CodeKi0303/split-beat-he-hardware/manufacturing/pcb/c86-panel-bom-R609-DNP-REVIEW.csv

Comment | Designator | Footprint | LCSC Part #
1206W4F1200T5E | R503,R553 | R_1206_3216Metric | C17909
74437324022 | L220,L320 | L_Wuerth_74437324022 | C2651177
AO3401A | Q212,Q312 | SOT-23 | C15127
BLM18PG121SN1D | FB210,FB310 | L_0603_1608Metric | C14709
C0805C475K4RACTU | C220,C235,C320,C335,C415,C417 | C_0805_2012Metric | C7224519
CPG151101S11-16 | SW1201,SW1204,SW1301,SW1304 | MX_Hotswap_Kailh_CPG151101S11_NPTH | C41430893
RC0603JR-070RL | R603 | R_0603_1608Metric | C95177
ECS-3225MV-240-CN-TR | X401 | ECS_3225MV_3.2x2.5mm | C405478
OXETDLJANF-25MHZ | X210,X310 | ECS_3225MV_3.2x2.5mm | C5382666
GRM1885C1H102JA01D | C1401,C1402,C1403,C1501,C1502,C1503 | C_0603_1608Metric | C77026
GRM188R71A225KE15D | C237,C238,C337,C338 | C_0603_1608Metric | C86018
GRM188R72A104KA35D | C1001,C1002,C1003,C1004,C1005,C1006,C1007,C1101,C1102,C1103,C1104,C1105,C1106,C1107,C211,C212,C221,C230,C231,C232,C233,C234,C236,C239,C311,C312,C321,C330,C331,C332,C333,C334,C336,C339,C410,C411,C412,C413,C414,C416,C418,C501,C551,C607,C608,C701 | C_0603_1608Metric | C77058
GRM21BR71C105KA01L | C240,C340,C401,C502,C552,C601,C602,C603,C604,C605,C606,C702 | C_0805_2012Metric | C77079
GRM21BR71C106KE51L | C222,C223,C322,C323 | C_0805_2012Metric | C408142
LM66100DCKR | U601,U603,U606 | SOT-363_SC-70-6 | C2869734
PEC11R-4215F-S0024 | ENC1401,ENC1501 | Bourns_PEC11R_4215F_S0024_Centered | C143790
RC0603FR-07100KL | R213,R215,R216,R221,R313,R315,R316,R321,R407,R501,R502,R504,R551,R552,R556,R601,R606 | R_0603_1608Metric | C14675
RC0603FR-0710KL | R1211,R1212,R1213,R1214,R1311,R1312,R1313,R1314,R1411,R1412,R1413,R1511,R1512,R1513,R214,R314,R404,R602,R604,R605,R607,R608 | R_0603_1608Metric | C98220
RC0603FR-0712KL | R405 | R_0603_1608Metric | C114659
RC0603FR-071KL | R1001,R1002,R1003,R1004,R1005,R1006,R1007,R1101,R1102,R1103,R1104,R1105,R1106,R1107,R1201,R1202,R1203,R1204,R1301,R1302,R1303,R1304,R1401,R1402,R1403,R1501,R1502,R1503 | R_0603_1608Metric | C22548
RC0603FR-07453KL | R220,R320 | R_0603_1608Metric | C273765
RC0603FR-074K7L | R701,R702 | R_0603_1608Metric | C99782
RC0603FR-075K1L | R401,R402,R554,R555 | R_0603_1608Metric | C105580
RC0603FR-07820RL | R403 | R_0603_1608Metric | C114638
SN74LVC1G32DBVR | U605 | SOT-23-5 | C10096
SS39ET | U1001,U1002,U1003,U1004,U1005,U1006,U1007,U1101,U1102,U1103,U1104,U1105,U1106,U1107 | SOT-23 | C126669
STM32H723VGT6 | U210,U310 | LQFP-100_14x14mm_P0.5mm | C730142
THVD1450DR | U501,U551 | SOIC-8_3.9x4.9mm_P1.27mm | C2671361
TLV62569DBVR | U220,U320 | SOT-23-5 | C141836
TPD1E10B06DYAR | D403,D504,D554 | D_SOD-523 | C3712135
TPD2E007DCKR | D502,D552 | SOT-323_SC-70 | C464811
TPD2E2U06DCKR | D402,D503,D553 | SOT-323_SC-70 | C1855726
TPD2EUSB30ADRTR | D401 | Texas_DRT-3 | C94934
TPS2552DBVR | U602 | SOT-23-6 | C46506
TS-1088-AR02016 | SW210,SW211,SW310,SW311 | SW_SPST_TS-1088-xR020 | C720477
FUSB303BTMX | U604 | onsemi_QFN12_722AG_1.6x1.6mm_P0.4mm | C895444
USB3300-EZK | U401 | QFN-32-1EP_5x5mm_P0.5mm_EP3.3x3.3mm | C108954
USB4105-GF-A-120 | J401,J501,J551 | USB_C_Receptacle_GCT_USB4105-xx-A_16P_TopMnt_Horizontal_JLC_NPTH | C5184243
PZ254R-11-05P | L_J74_SWD,R_J74_SWD | PinHeader_1x05_P2.54mm_Horizontal_C74_D1p1 | C492413
RC0603FR-07887KL | R610,R611 | R_0603_1608Metric | C246015
