CodeKi0303/split-beat-he-hardware/manufacturing/knob-bezels/D20-right-bezel-PRINT-FIT-TRIAL-NOT-ORDER.stl

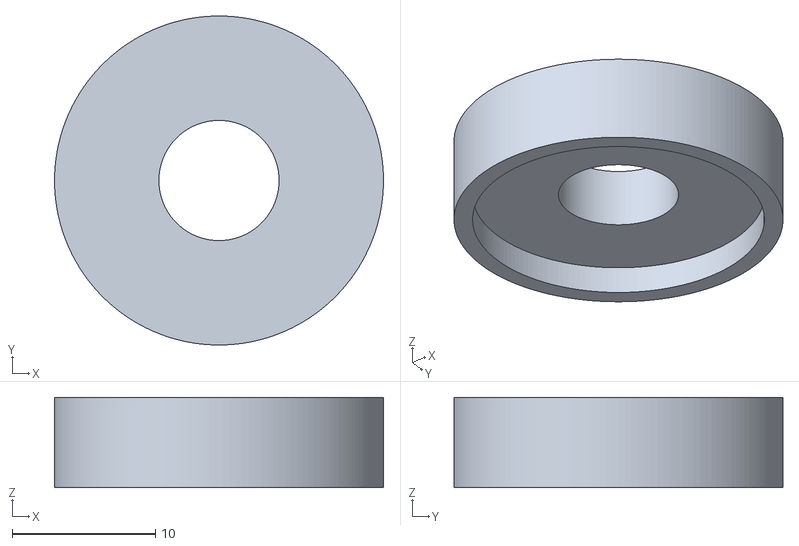
[picture p1: CAD file, 2026-11-08]
manufacturing/knob-bezels/D20-right-bezel-PRINT-FIT-TRIAL-NOT-ORDER.stl
23.0 x 23.0 x 6.30
