CodeKi0303/split-beat-he-hardware/manufacturing/plates/as-built/C77-R-LOWER-AL1p5-ALL-M3-WHEEL-CANDIDATE.step

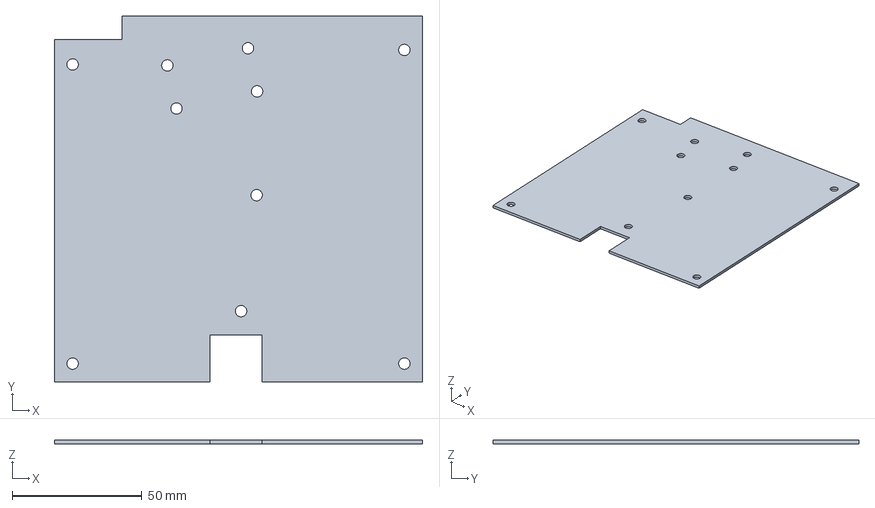
[picture p5: CAD file, 2026-11-08]
manufacturing/plates/as-built/C77-R-LOWER-AL1p5-ALL-M3-WHEEL-CANDIDATE.step
142.0 x 141.1 x 1.50 mm
