CodeKi0303/split-beat-he-hardware/manufacturing/plates/fit-candidate/FIT-CANDIDATE-L-LOWER-AL1p5-138x137p05.step

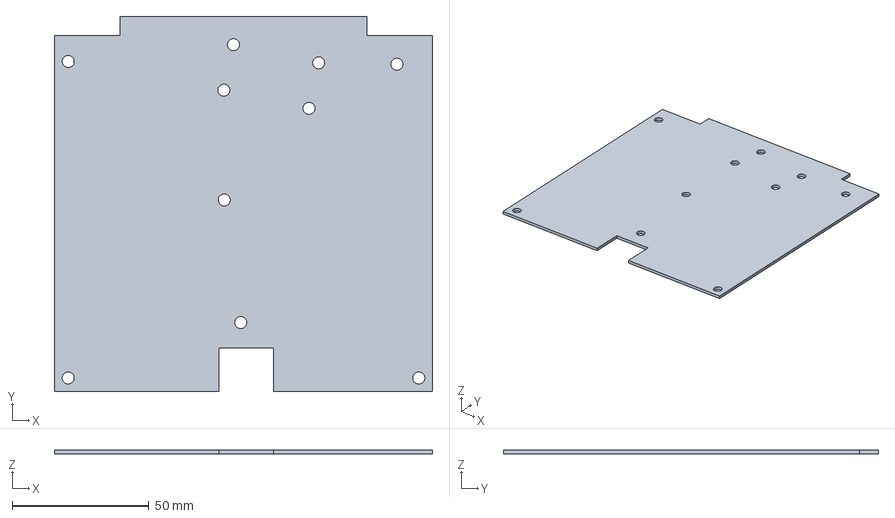
[picture p6: CAD file, 2026-11-08]
manufacturing/plates/fit-candidate/FIT-CANDIDATE-L-LOWER-AL1p5-138x137p05.step
138.0 x 137.1 x 1.50 mm
