CodeKi0303/split-beat-he-hardware/(list of files, cad)

Other CAD files:
manufacturing/knob-bezels/D20-left-bezel-PRINT-FIT-TRIAL-NOT-ORDER.stl
manufacturing/plates/fit-candidate/FIT-CANDIDATE-R-UPPER-AL1p5-138x137p05.step
manufacturing/knob-bezels/08-D20-LEFT-BEZEL.stl
manufacturing/plates/as-built/C80-R-UPPER-AL1p5-FIX-NELSON.step
manufacturing/plates/as-built/C77-L-LOWER-AL1p5-ALL-M3-WHEEL-CANDIDATE.dxf
manufacturing/plates/as-built/C77-R-LOWER-AL1p5-ALL-M3-WHEEL-CANDIDATE.dxf
manufacturing/plates/fit-candidate/FIT-CANDIDATE-L-LOWER-AL1p5-138x137p05.dxf
manufacturing/plates/fit-candidate/FIT-CANDIDATE-L-UPPER-AL1p5-138x137p05.dxf
manufacturing/plates/fit-candidate/FIT-CANDIDATE-R-LOWER-AL1p5-138x137p05.dxf
manufacturing/plates/fit-candidate/FIT-CANDIDATE-R-UPPER-AL1p5-138x137p05.dxf
