CodeKi0303/split-beat-he-hardware/pcb/board/split-hall-c86-four-layer-REVIEW-NOT-ORDER.kicad_pcb

## KiCad design pcb/board/split-hall-c86-four-layer-REVIEW-NOT-ORDER.kicad_pcb (2026-11-08)

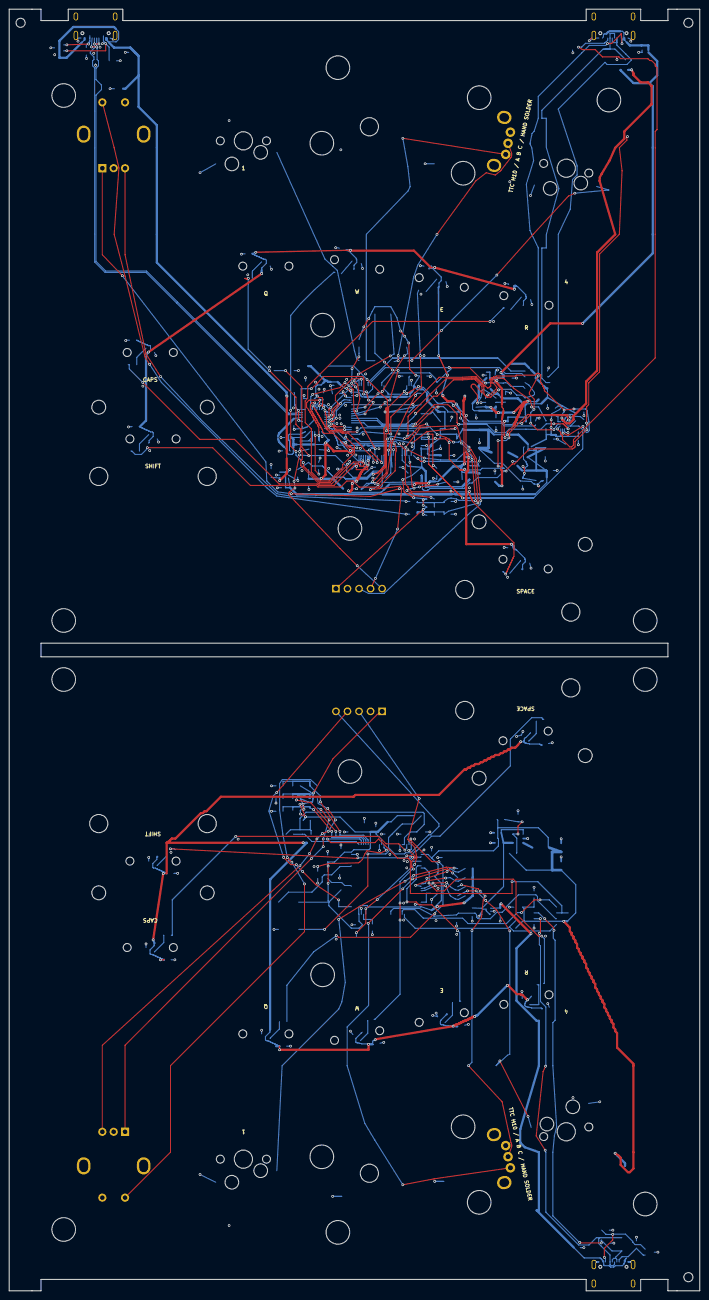
[picture p7: board split-hall-c86-four-layer-REVIEW-NOT-ORDER.kicad_pcb from above]

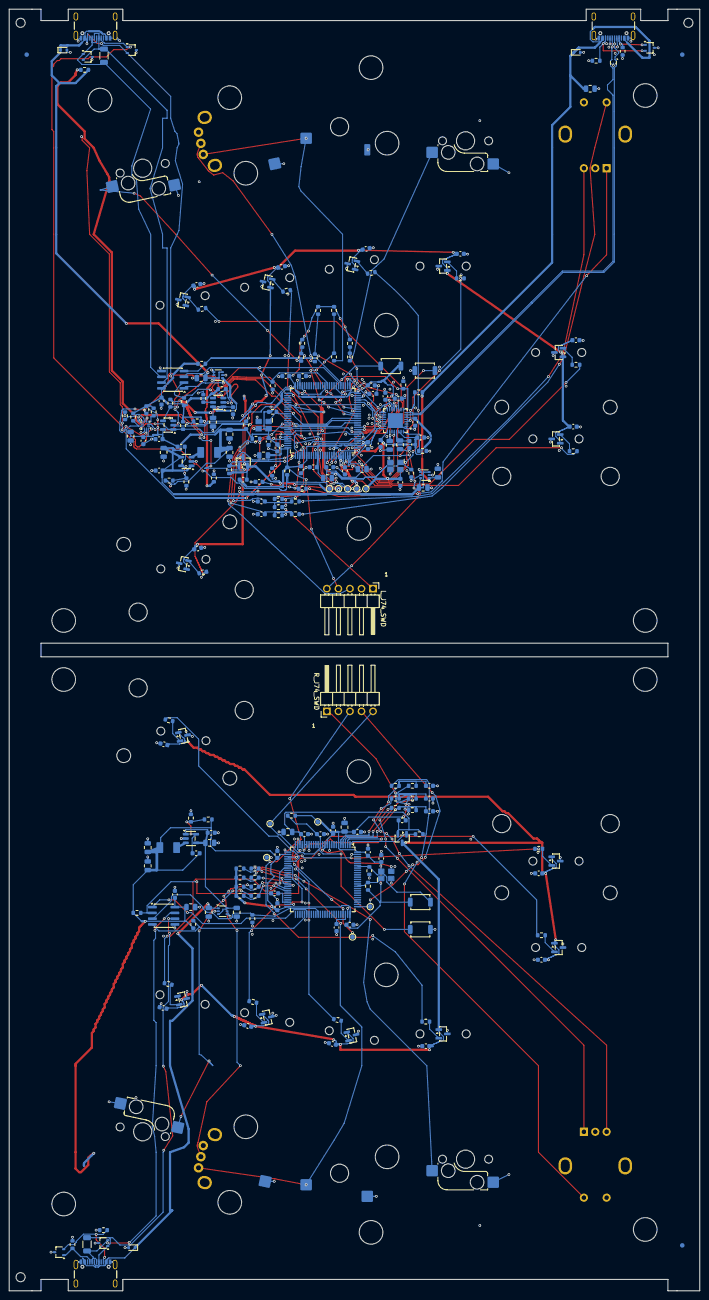
[picture p8: board split-hall-c86-four-layer-REVIEW-NOT-ORDER.kicad_pcb from below]

Board: 4 copper layers, 152.0 x 282.1 mm, 307 parts (236 on the bottom side), 143 nets.

Parts:
C211, C212, C221, C230, C231, C232, C233, C234, C236, C239, C311, C312, C321, C330, C331, C332, C333, C334, C336, C339, C410, C411, C412, C413, C414, C416, C418, C501, C551, C607, C608, C701, C1001, C1002, C1003, C1004, C1005, C1006, C1007, C1101, C1102, C1103, C1104, C1105, C1106, C1107: GRM188R72A104KA35D; C_0603_1608Metric
C220, C235, C320, C335, C415, C417: C0805C475K4RACTU; C_0805_2012Metric
C222, C223, C322, C323: GRM21BR71C106KE51L; C_0805_2012Metric
C237, C238, C337, C338: GRM188R71A225KE15D; C_0603_1608Metric
C240, C340, C401, C502, C552, C601, C602, C603, C604, C605, C606, C702: GRM21BR71C105KA01L; C_0805_2012Metric
C1401, C1402, C1403, C1501, C1502, C1503: 1nF; C_0603_1608Metric
D401: TPD2EUSB30ADRTR; Texas_DRT-3
D402, D503, D553: TPD2E2U06DCKR; SOT-323_SC-70
D403, D504, D554: TPD1E10B06DYAR; D_SOD-523
D502, D552: TPD2E007DCKR; SOT-323_SC-70
ENC1401, ENC1501: PEC11R-4215F-S0024; Bourns_PEC11R_4215F_S0024_Centered
FB210, FB310: BLM18PG121SN1D; L_0603_1608Metric
J401, J501, J551: USB4105-GF-A-120; USB_C_Receptacle_GCT_USB4105-xx-A_16P_TopMnt_Horizontal_JLC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
L220, L320: 74437324022; L_Wuerth_74437324022
L_C43_CS1, L_C43_CS2: M3 L5 sleeve / NPTH5.2; MountingHole_3.3mm_C35_M3Stack
L_C77_B1_1, L_C77_B1_2, L_C77_B2_1, L_C77_B2_2: M3 sleeve OD4 L8 / bearing post NPTH5.2; MountingHole_5.2mm_C77_BearingPost
L_C224: 6.8pF; C_0603_1608Metric
L_H1001A, L_H1001B, L_H1002A, L_H1002B, L_H1003A, L_H1003B, L_H1004A, L_H1004B, L_H1005A, L_H1005B, L_H1006A, L_H1006B, L_H1007A, L_H1007B: HE_LOCATOR_COMMON_PATTERN
L_H1006S1, L_H1006S2, L_H1006S3, L_H1006S4, L_H1007S1, L_H1007S2, L_H1007S3, L_H1007S4: STABILIZER_COMMON_2U_PATTERN
L_J74_SWD: PZ254R-11-05P; PinHeader_1x05_P2.54mm_Horizontal_C74_D1p1
L_J1202: TTC H10 DIRECT THT + optional wire lands; TTC_H10_Direct_left
L_MH1, L_MH2, L_MH3, L_MH4: M3 L5 sleeve / NPTH5.2
L_TP201: VTREF; TestPoint_Pad_D1.0mm
L_TP202: GND; TestPoint_Pad_D1.0mm
L_TP203: SWDIO; TestPoint_Pad_D1.0mm
L_TP204: SWCLK; TestPoint_Pad_D1.0mm
L_TP205: NRST; TestPoint_Pad_D1.0mm
L_WIRE_L: WIRE PASSAGE D4.0 / NO FASTENER; Roller_WirePassage_D4mm
PANEL_FID1, PANEL_FID2, PANEL_FID3: BOTTOM PANEL FIDUCIAL 1mm Cu 2mm mask
PANEL_H1, PANEL_H2, PANEL_H3: PANEL TOOLING NPTH 2mm
Q212, Q312: AO3401A; SOT-23
R213, R215, R216, R221, R313, R315, R316, R321, R407, R501, R502, R504, R551, R552, R556, R601, R606, R609: RC0603FR-07100KL; R_0603_1608Metric
R214, R314, R404, R602, R604, R605, R607, R608, R1211, R1212, R1213, R1214, R1311, R1312, R1313, R1314: RC0603FR-0710KL; R_0603_1608Metric
R220, R320: RC0603FR-07453KL; R_0603_1608Metric
R401, R402, R554, R555: RC0603FR-075K1L; R_0603_1608Metric
R403: RC0603FR-07820RL; R_0603_1608Metric
R405: RC0603FR-0712KL; R_0603_1608Metric
R503, R553: 1206W4F1200T5E; R_1206_3216Metric
R603: RC0603JR-070RL; R_0603_1608Metric
R610, R611: RC0603FR-07887KL; R_0603_1608Metric
R701, R702: RC0603FR-074K7L; R_0603_1608Metric
R1001, R1002, R1003, R1004, R1005, R1006, R1007, R1101, R1102, R1103, R1104, R1105, R1106, R1107, R1201, R1202, R1203, R1204, R1301, R1302, R1303, R1304: RC0603FR-071KL; R_0603_1608Metric
R1401, R1402, R1403, R1501, R1502, R1503: 1k; R_0603_1608Metric
R1411, R1412, R1413, R1511, R1512, R1513: 10k; R_0603_1608Metric
R_C43_CS1, R_C43_CS2: M3 L5 sleeve / NPTH5.2; MountingHole_3.3mm_C35_M3Stack
R_C77_B1_1, R_C77_B1_2, R_C77_B2_1, R_C77_B2_2: M3 sleeve OD4 L8 / bearing post NPTH5.2; MountingHole_5.2mm_C77_BearingPost
R_C324: 6.8pF; C_0603_1608Metric
R_H1101A, R_H1101B, R_H1102A, R_H1102B, R_H1103A, R_H1103B, R_H1104A, R_H1104B, R_H1105A, R_H1105B, R_H1106A, R_H1106B, R_H1107A, R_H1107B: HE_LOCATOR_COMMON_PATTERN
R_H1106S1, R_H1106S2, R_H1106S3, R_H1106S4, R_H1107S1, R_H1107S2, R_H1107S3, R_H1107S4: STABILIZER_COMMON_2U_PATTERN
R_J74_SWD: PZ254R-11-05P; PinHeader_1x05_P2.54mm_Horizontal_C74_D1p1
R_J1302: TTC H10 DIRECT THT + optional wire lands; TTC_H10_Direct_right
R_MH1, R_MH2, R_MH3, R_MH4: M3 L5 sleeve / NPTH5.2
R_TP301: VTREF; TestPoint_Pad_D1.0mm
R_TP302: GND; TestPoint_Pad_D1.0mm
R_TP303: SWDIO; TestPoint_Pad_D1.0mm
R_TP304: SWCLK; TestPoint_Pad_D1.0mm
R_TP305: NRST; TestPoint_Pad_D1.0mm
R_WIRE_R: WIRE PASSAGE D4.0 / NO FASTENER; Roller_WirePassage_D4mm
SW210, SW211, SW310, SW311: TS-1088-AR02016; SW_SPST_TS-1088-xR020
SW1201, SW1204, SW1301, SW1304: CPG151101S11; MX_Hotswap_Kailh_CPG151101S11_NPTH
U210, U310: STM32H723VGT6; LQFP-100_14x14mm_P0.5mm
U220, U320: TLV62569DBVR; SOT-23-5
U401: USB3300-EZK; QFN-32-1EP_5x5mm_P0.5mm_EP3.3x3.3mm
U501, U551: THVD1450DR; SOIC-8_3.9x4.9mm_P1.27mm
U601, U603, U606: LM66100DCKR; SOT-363_SC-70-6
U602: TPS2552DBVR; SOT-23-6
U604: FUSB303BTMX; onsemi_QFN12_722AG_1.6x1.6mm_P0.4mm
U605: SN74LVC1G32DBVR; SOT-23-5
U1001, U1002, U1003, U1004, U1005, U1006, U1007, U1101, U1102, U1103, U1104, U1105, U1106, U1107: SS39ET; SOT-23
X210, X310: OXETDLJANF-25MHZ; ECS_3225MV_3.2x2.5mm
X401: ECS-3225MV-240-CN-TR; ECS_3225MV_3.2x2.5mm

Connections:
L_CC_ADDR_STRAP: R611.1, U604.5 (ADDR / 0x47)
L_CC_EN_N: R609.2, U210.45 (PE15), U604.11 (EN_N)
L_CC_ID_N: R604.2, U210.38 (PE8), U604.9 (ID / attach_N), U605.1 (A)
L_CC_INT_N: R605.2, U210.37 (PE7), U604.6 (INT_N)
L_CC_PORT_STRAP: R610.1, U604.3 (PORT / DFP)
L_CC_SCL: R702.2, U210.95 (PB8), U604.8 (SCL)
L_CC_SDA: R701.2, U210.96 (PB9), U604.7 (SDA)
L_CC_VBUS_DET: R603.2, U604.4 (VBUS_DET)
L_GND: C211.2, C212.2, C220.2, C221.2, C222.2, C223.2, C230.2, C231.2, C232.2, C233.2, C234.2, C235.2, C236.2, C237.2, C238.2, C239.2, C240.2, C401.2, C410.2, C411.2, C412.2, C413.2, C414.2, C415.2, C416.2, C417.2, C418.2, C501.2, C502.2, C601.2, C602.2, C603.2, C604.2, C607.2, C608.2, C701.2, C702.2, C1001.2, C1002.2, C1003.2, C1004.2, C1005.2, C1006.2, C1007.2, C1401.2, C1402.2, C1403.2, D401.3 (GND), D402.3 (GND), D403.2 (GND), D502.3 (GND), D503.3 (GND), D504.2 (GND), ENC1401.C (COMMON), ENC1401.MP1 (SHIELD), ENC1401.MP2 (SHIELD), ENC1401.S2 (SW_COMMON), J401.A1 (GND (x4)), J401.A12 (GND (x4)), J401.B1 (GND (x4)), J401.B12 (GND (x4)), J401.SH (SHIELD), J501.A1 (GND (x4)), J501.A12 (GND (x4)), J501.B1 (GND (x4)), J501.B12 (GND (x4)), J501.SH (SHIELD), L_J74_SWD.2, L_J1202.1, L_TP202.1 (GND), R215.2, R221.2, R401.2, R402.2, R404.2, R405.2, R407.2, R501.2, R601.2, R608.2, R611.2, SW210.2, SW1201.2 (GND), SW1204.2 (GND), U210.10 (VSS x5), U210.19 (VSSA), U210.26 (VSS x5), U210.49 (VSS x5), U210.74 (VSS x5), U210.99 (VSS x5), U220.2 (GND), U401.1 (GND + EP33), U401.2 (GND + EP33), U401.33 (GND + EP33), U501.5 (GND), U601.2 (GND), U601.4 (NC), U601.5 (ST unused), U602.2 (GND), U603.2 (GND), U603.4 (NC), U603.5 (ST unused), U604.10 (GND), U605.3 (GND), U1001.3 (GND), U1002.3 (GND), U1003.3 (GND), U1004.3 (GND), U1005.3 (GND), U1006.3 (GND), U1007.3 (GND), X210.2 (GND), X401.2 (GND)
L_LINK_A: D502.1 (A), J501.A6 (D+ (x2)), J501.B6 (D+ (x2)), R503.1, U501.6 (A)
L_LINK_B: D502.2 (B), J501.A7 (D- (x2)), J501.B7 (D- (x2)), R503.2, U501.7 (B)
L_L_3V3: C211.1, C222.1, C223.1, C230.1, C231.1, C232.1, C233.1, C234.1, C235.1, C236.1, C410.1, C411.1, C412.1, C413.1, C418.1, C501.1, C502.1, C607.1, C701.1, C702.1, FB210.1, L220.2, L_C224.1, L_J74_SWD.1, L_TP201.1 (VTREF), R213.1, R214.1, R220.1, R502.1, R504.1, R602.1, R604.1, R605.1, R606.1, R609.1, R610.2, R701.1, R702.1, R1211.1, R1212.1, R1213.1, R1214.1, R1411.1, R1412.1, R1413.1, SW211.1, U210.6 (VBAT), U210.11 (VDD x5), U210.27 (VDD x5), U210.50 (VDD x5), U210.75 (VDD x5), U210.100 (VDD x5), U401.6 (VDD3.3 x4), U401.16 (VDD3.3 x4), U401.25 (VDD3.3 x4), U401.30 (VDD3.3 x4), U401.31 (REG_EN), U501.8 (VCC), U604.12 (VDD), U605.5 (VCC), X210.4 (VDD), X401.4 (VDD)
L_L_5V: C220.1, C221.1, C602.1, C608.1, R607.1, U220.1 (EN), U220.4 (VIN), U601.3 (CE), U601.6 (VOUT), U602.1 (IN)
L_L_A3V3: C239.1, C240.1, FB210.2, Q212.2 (S), R216.1, U210.20 (VREF+), U210.21 (VDDA)
L_L_ADC1: R1001.2, U210.22 (PA0)
L_L_ADC2: R1002.2, U210.23 (PA1)
L_L_ADC3: R1003.2, U210.24 (PA2)
L_L_ADC4: R1004.2, U210.32 (PC4)
L_L_ADC5: R1005.2, U210.33 (PC5)
L_L_ADC6: R1006.2, U210.28 (PA4)
L_L_ADC7: R1007.2, U210.30 (PA6)
L_L_BOOT0: R215.1, SW211.2, U210.94 (BOOT0)
L_L_BUCK_FB: L_C224.2, R220.2, R221.1, U220.5 (FB)
L_L_BUCK_SW: L220.1, U220.3 (SW)
L_L_CC1: D503.1 (CC1), J501.A5 (CC1), U604.1 (CC1)
L_L_CC2: D503.2 (CC2), J501.B5 (CC2), U604.2 (CC2)
L_L_DE: R501.1, U210.61 (PD14), U501.3 (DE)
L_L_HALL1: R1001.1, U1001.2 (OUT)
L_L_HALL2: R1002.1, U1002.2 (OUT)
L_L_HALL3: R1003.1, U1003.2 (OUT)
L_L_HALL3V3: C1001.1, C1002.1, C1003.1, C1004.1, C1005.1, C1006.1, C1007.1, Q212.3 (D), U1001.1 (VCC), U1002.1 (VCC), U1003.1 (VCC), U1004.1 (VCC), U1005.1 (VCC), U1006.1 (VCC), U1007.1 (VCC)
L_L_HALL4: R1004.1, U1004.2 (OUT)
L_L_HALL5: R1005.1, U1005.2 (OUT)
L_L_HALL6: R1006.1, U1006.2 (OUT)
L_L_HALL7: R1007.1, U1007.2 (OUT)
L_L_HALL_EN_N: Q212.1 (G), R216.2, U210.1 (PE2)
L_L_HSE25: U210.12 (PH0), X210.3 (OUT25MHz)
L_L_HSE_EN: R213.2, U210.85 (PD4), X210.1 (OE)
L_L_KEY1_N: R1201.2, R1211.2, U210.40 (PE10)
L_L_KEY4_N: R1204.2, R1214.2, U210.43 (PE13)
L_L_KNOB_A: ENC1401.A, R1401.1
L_L_KNOB_A_GPIO: C1401.1, R1401.2, R1411.2, U210.3 (PE4)
L_L_KNOB_B: ENC1401.B, R1402.1
L_L_KNOB_B_GPIO: C1402.1, R1402.2, R1412.2, U210.4 (PE5)
L_L_KNOB_SW: ENC1401.S1 (SW), R1403.1
L_L_KNOB_SW_GPIO: C1403.1, R1403.2, R1413.2, U210.5 (PE6)
L_L_LINK_RE_N: R504.2, U210.2 (PE3), U501.2 (/RE)
L_L_NRST: C212.1, L_J74_SWD.5, L_TP205.1 (NRST), R214.2, SW210.1, U210.14 (NRST)
L_L_ROLL_A: L_J1202.2, R1202.1
L_L_ROLL_A_GPIO: R1202.2, R1212.2, U210.41 (PE11)
L_L_ROLL_B: L_J1202.3, R1203.1
L_L_ROLL_B_GPIO: R1203.2, R1213.2, U210.42 (PE12)
L_L_RX: U210.56 (PD9), U501.1 (R)
L_L_SW1: R1201.1, SW1201.1 (CONTACT)
L_L_SW4: R1204.1, SW1204.1 (CONTACT)
L_L_SWCLK: L_J74_SWD.4, L_TP204.1 (SWCLK), U210.76 (PA14)
L_L_SWDIO: L_J74_SWD.3, L_TP203.1 (SWDIO), U210.72 (PA13)
L_L_TX: R502.2, U210.55 (PD8), U501.4 (D)
L_L_VCAP1: C237.1, U210.48 (VCAP1)
L_L_VCAP2: C238.1, U210.73 (VCAP2)
L_PC_CC1: D402.1 (CC1), J401.A5 (CC1), R401.1
L_PC_CC2: D402.2 (CC2), J401.B5 (CC2), R402.1
L_PHY_1V8A: C416.1, C417.1, U401.29 (VDDA1.8 analog)
L_PHY_1V8D: C414.1, C415.1, U401.15 (VDD1.8 digital), U401.26 (VDD1.8 digital)
L_PHY_RBIAS: R405.1, U401.32 (RBIAS)
L_PHY_RESET: R404.1, U210.57 (PD10), U401.9 (RESET (HIGH))
L_PHY_VBUS: R403.2, U401.4 (VBUS)
L_PHY_XI: U401.28 (XI), X401.3 (OUT24MHz)
L_PHY_XO_EN: R407.1, U210.81 (PD0), X401.1 (OE)
L_PWR_BLOCK: R606.2, U210.62 (PD15), U605.2 (B)
L_PWR_EN_N: R607.2, U602.3 (/EN), U605.4 (Y = A OR B)
L_PWR_FAULT_N: R602.2, U210.39 (PE9), U602.4 (/FAULT)
L_R_ILIM: R601.1, U602.5 (ILIM)
L_SPLIT_VBUS: C604.1, D504.1 (VBUS), J501.A4 (VBUS (x4)), J501.A9 (VBUS (x4)), J501.B4 (VBUS (x4)), J501.B9 (VBUS (x4)), R603.1, R608.1, U603.3 (CE), U603.6 (VOUT)
L_SW_5V: C603.1, U602.6 (OUT), U603.1 (VIN)
L_ULPI_CLK: U210.29 (PA5), U401.14 (CLKOUT60MHz)
L_ULPI_D0: U210.25 (PA3), U401.24 (DATA0)
L_ULPI_D1: U210.34 (PB0), U401.23 (DATA1)
L_ULPI_D2: U210.35 (PB1), U401.22 (DATA2)
L_ULPI_D3: U210.46 (PB10), U401.21 (DATA3)
L_ULPI_D4: U210.47 (PB11), U401.20 (DATA4)
L_ULPI_D5: U210.51 (PB12), U401.19 (DATA5)
L_ULPI_D6: U210.52 (PB13), U401.18 (DATA6)
L_ULPI_D7: U210.91 (PB5), U401.17 (DATA7)
L_ULPI_DIR: U210.17 (PC2_C), U401.12 (DIR)
L_ULPI_NXT: U210.18 (PC3_C), U401.11 (NXT)
L_ULPI_STP: U210.15 (PC0), U401.13 (STP)
L_USB_HS_DM: D401.2 (D-), J401.A7 (D- (x2)), J401.B7 (D- (x2)), U401.8 (DM)
L_USB_HS_DP: D401.1 (D+), J401.A6 (D+ (x2)), J401.B6 (D+ (x2)), U401.7 (DP)
L_USB_VBUS: C401.1, C601.1, D403.1 (VBUS), J401.A4 (VBUS (x4)), J401.A9 (VBUS (x4)), J401.B4 (VBUS (x4)), J401.B9 (VBUS (x4)), R403.1, U601.1 (VIN)
R_GND: C311.2, C312.2, C320.2, C321.2, C322.2, C323.2, C330.2, C331.2, C332.2, C333.2, C334.2, C335.2, C336.2, C337.2, C338.2, C339.2, C340.2, C551.2, C552.2, C605.2, C606.2, C1101.2, C1102.2, C1103.2, C1104.2, C1105.2, C1106.2, C1107.2, C1501.2, C1502.2, C1503.2, D552.3 (GND), D553.3 (GND), D554.2 (GND), ENC1501.C (COMMON), ENC1501.MP1 (SHIELD), ENC1501.MP2 (SHIELD), ENC1501.S2 (SW_COMMON), J551.A1 (GND (x4)), J551.A12 (GND (x4)), J551.B1 (GND (x4)), J551.B12 (GND (x4)), J551.SH (SHIELD), R315.2, R321.2, R551.2, R554.2, R555.2, R_J74_SWD.2, R_J1302.1 (GND_COMMON), R_TP302.1 (GND), SW310.2, SW1301.2 (GND), SW1304.2 (GND), U310.10 (VSS x5), U310.19 (VSSA), U310.26 (VSS x5), U310.49 (VSS x5), U310.74 (VSS x5), U310.99 (VSS x5), U320.2 (GND), U551.5 (GND), U606.2 (GND), U606.4 (NC), U606.5 (ST unused), U1101.3 (GND), U1102.3 (GND), U1103.3 (GND), U1104.3 (GND), U1105.3 (GND), U1106.3 (GND), U1107.3 (GND), X310.2 (GND)
R_LINK_A: D552.1 (A), J551.A6 (D+ (x2)), J551.B6 (D+ (x2)), R553.1, U551.6 (A)
R_LINK_B: D552.2 (B), J551.A7 (D- (x2)), J551.B7 (D- (x2)), R553.2, U551.7 (B)
R_R_3V3: C311.1, C322.1, C323.1, C330.1, C331.1, C332.1, C333.1, C334.1, C335.1, C336.1, C551.1, C552.1, FB310.1, L320.2, R313.1, R314.1, R320.1, R552.1, R556.1, R1311.1, R1312.1, R1313.1, R1314.1, R1511.1, R1512.1, R1513.1, R_C324.1, R_J74_SWD.1, R_TP301.1 (VTREF), SW311.1, U310.6 (VBAT), U310.11 (VDD x5), U310.27 (VDD x5), U310.50 (VDD x5), U310.75 (VDD x5), U310.100 (VDD x5), U551.8 (VCC), X310.4 (VDD)
R_R_5V: C320.1, C321.1, C606.1, U320.1 (EN), U320.4 (VIN), U606.3 (CE), U606.6 (VOUT)
R_R_A3V3: C339.1, C340.1, FB310.2, Q312.2 (S), R316.1, U310.20 (VREF+), U310.21 (VDDA)
R_R_ADC1: R1101.2, U310.22 (PA0)
R_R_ADC2: R1102.2, U310.23 (PA1)
R_R_ADC3: R1103.2, U310.24 (PA2)
R_R_ADC4: R1104.2, U310.32 (PC4)
R_R_ADC5: R1105.2, U310.33 (PC5)
R_R_ADC6: R1106.2, U310.28 (PA4)
R_R_ADC7: R1107.2, U310.30 (PA6)
R_R_BOOT0: R315.1, SW311.2, U310.94 (BOOT0)
R_R_BUCK_FB: R320.2, R321.1, R_C324.2, U320.5 (FB)
R_R_BUCK_SW: L320.1, U320.3 (SW)
R_R_CC1: D553.1 (CC1), J551.A5 (CC1), R554.1
R_R_CC2: D553.2 (CC2), J551.B5 (CC2), R555.1
R_R_DE: R551.1, U310.61 (PD14), U551.3 (DE)
R_R_HALL1: R1101.1, U1101.2 (OUT)
R_R_HALL2: R1102.1, U1102.2 (OUT)
R_R_HALL3: R1103.1, U1103.2 (OUT)
R_R_HALL3V3: C1101.1, C1102.1, C1103.1, C1104.1, C1105.1, C1106.1, C1107.1, Q312.3 (D), U1101.1 (VCC), U1102.1 (VCC), U1103.1 (VCC), U1104.1 (VCC), U1105.1 (VCC), U1106.1 (VCC), U1107.1 (VCC)
R_R_HALL4: R1104.1, U1104.2 (OUT)
R_R_HALL5: R1105.1, U1105.2 (OUT)
R_R_HALL6: R1106.1, U1106.2 (OUT)
R_R_HALL7: R1107.1, U1107.2 (OUT)
R_R_HALL_EN_N: Q312.1 (G), R316.2, U310.1 (PE2)
R_R_HSE25: U310.12 (PH0), X310.3 (OUT25MHz)
R_R_HSE_EN: R313.2, U310.85 (PD4), X310.1 (OE)
R_R_KEY1_N: R1301.2, R1311.2, U310.40 (PE10)
R_R_KEY4_N: R1304.2, R1314.2, U310.43 (PE13)
R_R_KNOB_A: ENC1501.A, R1501.1
R_R_KNOB_A_GPIO: C1501.1, R1501.2, R1511.2, U310.3 (PE4)
R_R_KNOB_B: ENC1501.B, R1502.1
R_R_KNOB_B_GPIO: C1502.1, R1502.2, R1512.2, U310.4 (PE5)
R_R_KNOB_SW: ENC1501.S1 (SW), R1503.1
R_R_KNOB_SW_GPIO: C1503.1, R1503.2, R1513.2, U310.5 (PE6)
R_R_LINK_RE_N: R556.2, U310.2 (PE3), U551.2 (/RE)
R_R_NRST: C312.1, R314.2, R_J74_SWD.5, R_TP305.1 (NRST), SW310.1, U310.14 (NRST)
R_R_ROLL_A: R1302.1, R_J1302.2 (A_PE11)
R_R_ROLL_A_GPIO: R1302.2, R1312.2, U310.41 (PE11)
R_R_ROLL_B: R1303.1, R_J1302.3
R_R_ROLL_B_GPIO: R1303.2, R1313.2, U310.42 (PE12)
R_R_RX: U310.56 (PD9), U551.1 (R)
R_R_SW1: R1301.1, SW1301.1 (CONTACT)
R_R_SW4: R1304.1, SW1304.1 (CONTACT)
R_R_SWCLK: R_J74_SWD.4, R_TP304.1 (SWCLK), U310.76 (PA14)
R_R_SWDIO: R_J74_SWD.3, R_TP303.1 (SWDIO), U310.72 (PA13)
R_R_TX: R552.2, U310.55 (PD8), U551.4 (D)
R_R_VCAP1: C337.1, U310.48 (VCAP1)
R_R_VCAP2: C338.1, U310.73 (VCAP2)
R_SPLIT_VBUS: C605.1, D554.1 (VBUS), J551.A4 (VBUS (x4)), J551.A9 (VBUS (x4)), J551.B4 (VBUS (x4)), J551.B9 (VBUS (x4)), U606.1 (VIN)
