CodeKi0303/split-beat-he-hardware/(notices)

Notices in the files:
parts and their libraries:
C.8: marbastlib CPG151101S11 adapted 2026-09-14: unplated contact bores, no copper reinforcement bridges, 4.0 mm central bore. Socket pads on F in library; Flip to B for top-inserted MX switch. Retain vendor CERN-OHL-P notice.
